GityUpNow/SOMA-Junction/README.md

# SOMA-Junction
A junction box to simlify the installation of the "Summer of Media Arts" lighting

## Sources
* The SW_DP3T is a doubled version of the SW_SP3T from the official KiCAD-Libraries.<br>
  [The KiCAD-Libraries are released under the CC-4.0-BY-SA](http://kicad-pcb.org/libraries/license/)
* The MountingHole_Custom:MountingHole_3.2mm_M3_Clearance1.6mm is a modifierd version of the MountingHole:MountingHole_3.2mm_M3 from the official KiCAD-Libraries.<br>
  [The KiCAD-Libraries are released under the CC-4.0-BY-SA](http://kicad-pcb.org/libraries/license/)

## License
<span xmlns:dct="http://purl.org/dc/terms/" property="dct:title">SOMA-Junction</span> by <a xmlns:cc="http://creativecommons.org/ns#" href="https://zkm.de" property="cc:attributionName" rel="cc:attributionURL">Simon "GityUpNow" Rätzer / ZKM</a> is licensed under a <a rel="license" href="http://creativecommons.org/licenses/by-sa/4.0/">Creative Commons Attribution-ShareAlike 4.0 International License</a>.<br/>
