GityUpNow/SOMA-Junction/(commit log)

2019-05-11 Added project skeleton
    [junction.kicad_pcb, junction.sch]
2019-05-11 Made Rotary-Switch Connections
    [junction.sch]
2019-05-11 Placed and wired connectors
    [junction.sch]
2019-05-12 Created double throw switch frow SPDT_MSM
2019-05-12 Created 36V for remaining connectors(better readability of the schematic)
    [junction.sch]
2019-05-12 Power-Switching configured
    [junction.sch]
2019-05-12 Added Power-Flags to fix ERC
    [junction.sch]
2019-05-12 Did initial annotation
    [junction.sch]
2019-05-12 Organized Schematic
    [junction.sch]
2019-05-12 Created footprint for RND RotarySwitch
2019-05-12 Created footprint for the MSM-Switch
2019-05-12 DPDT_MSM: Recentered anchor; fixed keywords; added datasheet; set footprint
2019-05-12 Moved Switch to reflect new anchor
    [junction.sch]
2019-05-16 Created the missing TerminalBlock(with Clamps)
2019-05-16 Set In- and Output-Connectors to the new Metz-Terminal
    [junction.sch]
2019-05-16 Renamed DPDT_MSM Library to Switch_Custom(to enforce a common format)
    [junction.sch]
2019-05-16 Created DP3T-Symbol to replace the (too high) rotary Switch
2019-05-16 Replaced Rotary-Switch with DP3T-Slide-Switch(for height-reasons)
    [junction.sch]
2019-05-16 Built footprint for Rotary-Switch replacement
2019-05-16 Associated footprint for Data/Clock-Switch
    [junction.sch]
2019-05-16 Now using both sides of the Power-Switch(to better use the current rating)
    [junction.sch]
2019-05-16 Switched OrigData-Input from 0 to 1(to represent Board-Layout)
    [junction.sch]
2019-05-16 Set (temporary) board size; placed connectors; placed mounting holes
    [junction.kicad_pcb]
2019-05-16 Hid unnecessary Referenz for Mounting-Hole
    [junction.kicad_pcb]
2019-06-28 Resized pcb
    [junction.kicad_pcb]
2019-06-28 Added mounting holes for screws
    [junction.kicad_pcb]
2019-06-28 Positioned the cable holders
    [junction.kicad_pcb]
2019-06-28 Positioned the switches
    [junction.kicad_pcb]
2019-06-28 Routed data-signal
    [junction.kicad_pcb]
2019-06-29 Removed MSM-Switch
2019-06-29 Reworked Power-Switche to different configuration(for more configurability)
    [junction.sch]
2019-06-29 Rmoved current Data-Wiring
    [junction.kicad_pcb]
2019-06-29 Moved the components back onto the board
    [junction.kicad_pcb]
2019-06-29 Rerouted data-signals
    [junction.kicad_pcb]
2019-06-29 Routed power
    [junction.kicad_pcb]
2019-06-29 Created configuration instruction on the Silk-Screen
    [junction.kicad_pcb]
2019-06-29 Uncluttered the Silk-Screen
    [junction.kicad_pcb]
2019-06-29 Moved Resistor-Value to Silk-Screen
    [junction.kicad_pcb]
2019-06-29 Changed Mounting-Holes to insulated Mounting-Holes
    [junction.kicad_pcb]
2019-07-05 Changed the mounting hole to a version without copper
    [junction.kicad_pcb]
2019-07-06 Generated Gerber-Files
    [junction-B_Cu.gbr, junction-B_Mask.gbr, junction-B_SilkS.gbr, junction-Edge_Cuts.gbr, junction-F_Cu.gbr, junction-F_Mask.gbr, junction-F_SilkS.gbr, junction-NPTH.drl]
2019-07-18 Added Copyright-Notice and OSHW-Logo
    [junction.kicad_pcb]
2019-07-18 Added URL and CC
    [junction.kicad_pcb]
2019-07-18 Updated gerber-files to represent license
    [junction-B_Cu.gbr, junction-B_Mask.gbr, junction-B_SilkS.gbr, junction-Edge_Cuts.gbr, junction-F_Cu.gbr, junction-F_Mask.gbr, junction-F_SilkS.gbr, junction-NPTH.drl]
2019-07-25 Set the reference of the MountingHoles to invisible
    [junction.kicad_pcb]
2019-07-25 Regenerated gerber without MountingHole-REF
    [junction-B_Cu.gbr, junction-B_Mask.gbr, junction-B_SilkS.gbr, junction-Edge_Cuts.gbr, junction-F_Cu.gbr, junction-F_Mask.gbr, junction-F_SilkS.gbr, junction-NPTH.drl]
2019-08-02 Moved power-switches a few centimeter to avoid collision with the fasteners
    [junction.kicad_pcb]
2019-08-02 Turned drill references invisible
    [junction.kicad_pcb]
2019-08-02 Regenerated gerber files
    [junction-B_Cu.gbr, junction-B_Mask.gbr, junction-B_SilkS.gbr, junction-Edge_Cuts.gbr, junction-F_Cu.gbr, junction-F_Mask.gbr, junction-F_SilkS.gbr, junction-NPTH.drl]
