GityUpNow/SOMA-Junction/(notices)

Notices in the files:
junction.kicad_pcb:
CC-BY-SA 4.0
